MJW411/SIMPLX-SECOND-BARRIER/src/omx_core/config/default.yaml

# 시스템 설정. 현장 튜닝 값은 여기(또는 data/settings.json 의 제어판 변경값)에만 둔다.

robot:
  backend: real            # real | sim  (sim: 로봇 없이 시험)
  port: auto               # auto: /dev/serial/by-id 의 ROBOTIS 장치 (전원 재투입으로 ttyACM 번호가 바뀌어도 찾음)
  baud: 1000000
  ids: {joint1: 11, joint2: 12, joint3: 13, joint4: 14, joint5: 15, gripper: 16}
  control_hz: 50
  # 시간 기반 프로파일(Drive Mode 4)의 프로파일 시간(ms). 짧은 목표를 50Hz로 흘려보내므로
  # 프로그램이 죽어도 로봇은 마지막 작은 목표에서 멈춘다.
  profile_time_ms: 120
  profile_acc_ms: 40
  # 접힌 휴식 자세 (토크 끄기 전 이동). 공식 "home"은 j2=-1.57 이지만 실측 기구 멈춤점(-1.555)에 기대므로 -1.52.
  rest_pose: [0.0, -1.52, 1.57, 1.57, 0.0]
  home_after_done: true    # 정한 반복 횟수를 다 마치면 홈 자세로 복귀 (2026-10-12 사용자). 정지 버튼·안전 정지로 멈출 때는 복귀하지 않음
  bus_watchdog_ms: 0       # 0=끔. Dynamixel Bus Watchdog (20ms 단위로 반올림)
  # 그리퍼(XL330) 위치 이득. 모터 값(P 250 I 0 D 600)으로는 기구 마찰 때문에 목표보다 약 0.1 rad 덜 갔다
  # (2026-10-07 실측: 0.5→0.385, 0.9→0.79, 0→0.084, 전류는 한도의 30% 미만). 힘은 여전히 전류 한도(그리퍼 힘 %)로 묶인다.
  gripper_gains: {p: 500, i: 50}
  # 팔 관절 위치 이득 (XL430 기본 P 640 I 0 D 4000 — I 가 0 이라 중력·물건 무게로 처진 만큼이 그대로 남았다).
  # 2026-10-12: 팔을 뻗고 물건을 들면 어깨가 약 0.08 rad 처짐 → I 이득을 줘 모터가 스스로 되돌리게. 적은 것만 바꾼다.
  # 떨리거나 목표를 지나치면 I 를 줄인다.
  arm_gains: {joint2: {i: 300}, joint3: {i: 300}, joint4: {i: 150}}

camera:
  source: realsense        # realsense | video
  video_path: ""           # source=video 일 때 재생할 파일 (녹화 영상으로 시험)
  width: 640
  height: 480
  fps: 30                  # 2026-09-27: 15 → 30 (최적화로 여유 생김 — 화면 매끄럽고 판단 주기 67 → 33 ms)

perception:
  model: v2_best.engine       # ~/models 또는 data/models 안의 파일 이름. v2 통합 모델: 0=fall-down 1=helmet 2=human
  # direct: .engine 을 torch·ultralytics 없이 TensorRT 로 직접 실행 (실측 프로세스 1416 → 461 MB, 같은 검출 결과)
  # ultralytics: 기존 방식 (.pt/.onnx 는 항상 이쪽)
  backend: direct
  conf: 0.60               # 사람 인식 최소 확신도. 로봇이 person 0.60~0.63으로 잡혀 사용자 요청으로 0.30→0.60 (손 검출이 줄 수 있음)
  imgsz: 640
  # 사람으로 볼 클래스 '이름' (번호는 모델마다 다름). 넘어진 사람(fall-down)도 사람 — 거리·사라짐·재가동 검사에 모두 들어감.
  # COCO 모델이면 person 이 쓰인다. 이 중 하나도 없는 모델은 '인식 모델 없음'으로 고장 정지.
  person_classes: [human, fall-down, person]
  fallen_classes: [fall-down]   # 넘어진 사람 (낙상 알림·녹화용. 정지 판단에는 쓰지 않음)
  show_classes: [helmet]        # 작업 구역 영상에 마스크로 함께 표시만 하는 클래스 (안전 판단에는 안 씀, 2026-10-12)
  min_depth_pixels: 30
  depth_range: [0.12, 4.0]
  max_points: 400          # 사람 한 명당 거리 계산에 쓰는 3D 점 수 (다운샘플)
  stale_timeout: 1.0       # 인식 결과가 이 시간 이상 갱신 안 되면 고장(정지)
  min_brightness: 30       # 영상 평균 밝기가 이보다 1.5초 이상 낮으면 인식 불가 → 고장 정지 (불 꺼진 방)
  # 로봇 자기 오검출 필터: 사람 마스크의 max_frac 이상이 로봇 색(주황)이면 사람이 아니라 로봇으로 본다.
  # (실기 시험에서 움직이는 OMX 팔이 person 으로 간헐 검출돼 사라짐 정지가 걸린 문제 대응)
  robot_filter: {enabled: true, hsv_lo: [2, 190, 70], hsv_hi: [13, 255, 255], max_frac: 0.25}

safety:
  profile: figure          # figure(피규어 시연) | human(실제 사람)
  profiles:
    figure: {slow: 0.18, stop: 0.12, clear: 0.20}   # 13cm 피규어 = 실제 사람(약 166cm)의 1/12.8. ISO 13855 기준 정지 1.54 / 감속 2.30 / 해제 2.56m를 축소 (2026-10-09)
    human:  {slow: 2.30, stop: 1.54, clear: 2.56}   # ISO 13855: S = K·T + C = 1600mm/s × 0.43s + 850mm ≈ 1.54m, 감속 = 정지 + K·T, 해제 = 감속 + 0.26m (2026-10-09)
  # 제어판에서 저장할 수 있는 최소 정지 거리 (m). 실제 사람 기준이 5cm 로 덮어써져 있던 문제(2026-10-08) 재발 방지
  profile_min_stop: {figure: 0.03, human: 0.30}
  slow_scale: 0.35         # 감속 시 속도 배율
  confirm_frames: 3        # 연속 N 프레임 같은 판정이어야 감속/정지 진입 (30fps 에서 0.1초; 15fps 때 2프레임 = 0.13초)
  # 감시 구역 (로봇 베이스 기준, m). 보정 전에는 카메라 기준.
  zone_base: {x: [-0.6, 0.9], y: [-0.8, 0.8], z: [-0.2, 1.2]}
  # 사라짐 판정
  vanish_grace: 1.0        # 이 시간 안에 같은 위치에서 다시 보이면 사라짐 아님 (s)
  vanish_min_frames: 6     # 연속 N 프레임 이상 보인 사람만 사라짐 대상 (깜박이는 오검출 제외, 30fps 에서 0.2초)
  vanish_match_radius: 0.15  # 직전-현재 검출 1:1 매칭 반경 (m)
  vanish_match_iou: 0.3      # 또는 박스가 이만큼 겹치면 같은 사람 (넘어질 때 몸 중심이 크게 움직여도)
  fall_confirm_sec: 3.0      # 넘어진 사람이 이 시간 넘게 계속 보이면 낙상 알림·녹화 + 제어판 확인 팝업. 정지는 하지 않음
  fall_min_conf: 0.60        # 낙상으로 셀 최소 확신도 (2026-10-12 사용자: 60% 이상 3초 이상)
  fall_gap_sec: 0.5          # 이만큼 이하로 잠깐 놓친 건 계속 보인 것으로 (인식 깜빡임)
  fall_clear_frames: 30      # 넘어진 사람이 N 프레임 안 보이면 낙상 상태 해제
  exit_border_px: 40       # 화면 가장자리 이 폭 안에서 사라지면 출구로 본다
  door_roi_px: null        # [x1,y1,x2,y2] 출입문 영역 (이미지 좌표)

recording:
  segment_sec: 2
  keep_sec: 60
  fps: 15                  # 사고 영상 프레임 (10 → 15, 최적화로 여유)
  jpeg_quality: 70
  segment_dir: /dev/shm/omx_segments
  pre_sec: 8               # n
  post_sec: 16             # m (사람·사라짐)
  conveyor_post_sec: 16    # L (컨베이어)
  limits: {pre_max: 50, post_max: 120}

storage:
  # 데이터 폴더는 OMX_DATA_DIR 환경 변수로 정한다 (없으면 ~/omx_data). 시험은 임시 폴더를 지정.
  budget_ratio: 0.50       # SSD 전체 용량 대비 데이터 예산

conveyor:
  travel_timeout: 15.0     # 컨베이어가 돌기 시작한 뒤 도착 센서(D5)까지 제한시간 (s, 0=끔). 넘으면 정지 + 이상 이벤트·녹화·알림
  start_sensor: true       # 투입 센서(D6)에 물품이 올라오면 출발. false 면 작업 중 도착 센서가 빌 때마다 계속 돌림(예전 방식)
  arrive_sensor: true      # false = 도착 센서(D5)로 멈추지 않음 (센서 고장 시 임시. 아두이노도 안 멈춤 — 펌웨어 v4.1 이상)
                           # 2026-10-12 펌웨어 v4.3 재배선: 도착 센서 D5, 투입 센서 D6, 문 서보 D4
  auto_clear_sec: 0        # 컨베이어 이상이 걸린 뒤 이 시간(s)이 지나면 저절로 해제하고 로봇 작업을 이어서 함 (0 = 끔).
                           # 2026-10-12 사용자: 끔 — 제어판 '공정 이상' 팝업의 재가동 버튼으로 다시 실행.
                           # 물품이 도착 센서에 닿음·투입 센서에 새 물품·작업 새로 시작으로도 풀림
  resume_pose: place       # 컨베이어 이상으로 일시 정지된 로봇 작업이 재개될 때 먼저 이 티칭 자세로 가서 물품이 도착 센서(D5)에
                           # 올 때까지 기다린 뒤 이어서 함 (빈 값 = 멈춘 단계부터 바로 이어서)

devices:
  backend: arduino         # virtual | arduino  (--sim + 영상 파일 시험은 항상 virtual)
  arduino_port: auto       # auto: /dev/serial/by-id 의 FT232R·CH340 (로봇 장치 제외), 없으면 첫 /dev/ttyUSB*
  arduino_baud: 9600       # 스케치(arduino/omx_io)와 같아야 함. 네오픽셀 때문에 9600

door:
  close_sec: 5.0           # 헬멧 확인(또는 수동 열기) 뒤 이 시간이 지나면 닫힘. 화재 중에는 계속 열림

helmet:
  enabled: true
  camera: auto             # auto: /dev/v4l/by-id 에서 RealSense 가 아닌 첫 카메라
  fps: 5                   # 추론 프레임 (카메라는 30fps 로 받고 이만큼만 압축을 푼다)
  # 모델: 사람 인식과 같은 통합 모델을 다른 실행 통로로 같이 쓴다 (perception.model)
  match: presence          # head: 사람 머리 영역에 헬멧이 겹쳐야 착용 | presence: 사람과 헬멧이 함께 보이면 착용
                           # 2026-10-08 실기: 입구 카메라가 피규어를 가깝고 비스듬히 봐서 head 가 미착용으로 오판 → presence
  head_frac: 0.35          # head 방식: 사람 박스 위쪽 이 비율을 머리 영역으로 본다
  person_conf: 0.50        # 사람 검출 최소 확신도
  always: true             # 항상 판정 (피규어 시연: 서 있는 동안 계속 판정, 헬멧이면 문 열림 유지). false = 움직일 때만
  hold_sec: 3.0            # 움직임이 멈춘 뒤에도 이만큼 더 추론 (멈춰 선 사람도 연속 확인되게)
  conf: 0.50
  confirm_frames: 3        # 연속 N 프레임 착용이어야 문 열림 (5fps 에서 0.6초)

web:
  host: 0.0.0.0
  port: 8000
  users: {admin: omx1234}  # 첫 로그인 후 바꿀 것
