MJW411/SIMPLX-SECOND-BARRIER/(commit log)

2026-10-08 기존 ROS 2 패키지 보관 (COLCON_IGNORE)
    omx-safety-demo를 ROS 2 5-프로세스 구조로 이전하기 전의 기준점.
    기존 비전 감시 패키지는 빌드에서 제외하고 참고용으로 남긴다.
2026-10-08 omx_core: omx-safety-demo 원본 코드 복사 (변경 없음)
    demo 2e30b8a 이후 작업 트리 기준 (git 손상으로 커밋 해시 대신 2026-10-08 스냅샷).
    기준선 테스트: test_core 63 OK, test_io 42 OK, test_db OK, test_gpu 6 OK.
2026-10-08 omx_core: v2 통합 모델 적용과 인식·안전 허점 수정 (2단계)
    - 엔진 1개 + 실행 컨텍스트 2개(사람·헬멧 레인), 모델 교체 시 GPU 버퍼 해제
    - GPU 후보 선택을 클래스 비트마스크로 확장: human+fall-down 도 GPU 경로 (CPU 경로와 결과 동일)
    - 사람 클래스를 이름으로 조회, Person.fallen / Percept.model_ready 추가
    - 모델 로딩 실패·사람 클래스 없는 모델 → 인식 고장 정지, 교체 시 클래스·파일 이름 검증
    - 신선도를 프레임 시각 기준으로, 카메라 새 프레임 대기(5ms 폴링 제거)
    - 헬멧 게이트: 사람 머리 영역의 헬멧(head) / 동시 검출(presence), 예외 처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
2026-10-08 omx_core·omx_interfaces: 다중 프로세스 준비와 4단계 허점 수정
    - omx_interfaces: 노드 사이 메시지(People/Permit/RobotState/SafetyState/IoState/HelmetState/Event/ClipStatus)와 Command 서비스
    - Config: 설정 폴더 탐색(OMX_CONFIG_DIR/소스/ament), 데이터 폴더 기본 ~/omx_data,
    settings.json 파일 잠금 저장(다른 노드 값 보존) + reload
    - 녹화: 데이터 폴더별 조각 폴더, 쓰기·인코딩 예외 처리, ffmpeg 에 조각을 바로 흘려 SSD 이중 복사 제거
    - DB: 클립을 clips 폴더 기준으로 삭제(파일이 안 지워지던 버그), 이벤트 키 중복 방지, 시작 시 정리,
    사용량·통계 캐시, (type, acked)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
2026-10-08 ROS 2 5-프로세스 구조로 이전 (perception/safety/robot/io/web)
    - omx_nodes: 노드 5개 + 웹 제어판(데모와 같은 API·응답). 기존 판단·실행 코드는 대리 객체로 그대로 사용
    (ExecutorProxy/PerceptionProxy/IoProxy/SafetyProxy, 끊기면 안전 쪽으로)
    - 공통: 단일 스레드 실행기 + 명령은 작업 스레드, 바뀔 때만 보내는 상태, 볼 때만 보내는 스냅샷
    - 경합 수정: 동작 전 정비·화재 검사와 화재 상황 종료는 해당 노드의 지금 값으로,
    상황 종료 전 화재 값 무시, 명령 후 즉시 상태·스냅샷 발행, 웹은 첫 상태 수신 후 열기
    - 비상정지: /omx/estop 토픽으로 실행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
2026-10-08 장치 잠금: 실제 장치마다 배타 잠금, 백업 데모와 동시 실행 방지
    같은 OpenRB·아두이노·카메라를 두 프로그램이 함께 잡지 않게 한다. 데모의 잠금 파일에는 공유 잠금만 건다(내용 그대로).
2026-10-08 tools/live_view.py: v2 모델 실시간 확인 뷰어 (작업대·입구 카메라, 모든 클래스·확신도·거리)
2026-10-08 tools/upload_arduino.sh: 아두이노 펌웨어 업로드 (데모에서 가져옴)
2026-10-08 아두이노 omx_io v4 + 컨베이어 투입 센서 출발
    - 배선 v4 (사용자 시험 스케치 기준): 투입 D11·도착 D12 IR(감지 시 LOW), 화염 A0, 서보 D6, 모터 D9/D10,
    조명 D13(16개, 항상 백색), 대피 유도 D3(60개)
    - D3: 평상시 은은한 백색, 화재(불꽃 직접 감지 또는 젯슨 Y) 시 노란 물결이 입구 쪽으로 흐름
    - 서보는 움직일 때만 신호(LED 갱신 시 떨림 방지), 60개 LED 갱신은 시리얼 수신·서보 이동 중 미룸
    - 상태 줄 s1 = D11 투입 (v3 는 항상 0)
    - ConveyorMonitor: 작업 중 투입 센서에 물품이 있으면 출발, 도착까지 계속 (conveyor.start_sensor, 기본 true)
    - 시험: test_io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
2026-10-08 omx_io v4: 대피 유도 물결 간격 6칸·꼬리 5칸, 수신 대기 제거로 시험 스케치처럼 부드럽게
2026-10-08 omx_io v4: 대피 유도 물결 밝기 80% (사용자 조정)
2026-10-08 web_node: 자원 측정 스레드가 접속 수를 만들기 전에 읽던 순서 수정
2026-10-08 화재 홈 복귀: 팔만 움직이고 그리퍼는 지금 위치 유지
    저장된 홈 자세의 그리퍼 값이 한계를 살짝 벗어나(-0.02) 화재 홈 복귀 전체가 거부되던 문제 (2026-10-08 실기).
    대리 객체 current_q 도 실행기처럼 그리퍼를 한계 안으로.
2026-10-08 omx_io v4: 불꽃 센서 보류 — 감지 끔(FLAME_ENABLED=false), 기준값 300 (사용자 시험 스케치)
    실기: 단품 수광 소자 + 풀다운이 LED·조명 빛에 1023 포화 → 화재 오판, 센서 제거 후 A0 가 떠서 84~109 로 기준(100) 오르내림.
2026-10-08 헬멧 게이트: 움직임이 멈춘 뒤 3초 더 추론(hold_sec), 판정 방식 presence
    실기: 피규어를 놓고 손을 떼면 바로 '움직임 없음'이 돼 확인 횟수가 지워지고 박스가 사라짐.
    입구 카메라가 피규어를 가깝고 비스듬히 봐서 head(머리 영역) 판정이 미착용으로 오판 → 계획대로 presence 로 전환.
2026-10-08 헬멧 게이트: always 설정(기본 true) — 피규어 시연은 서 있는 동안 계속 판정
2026-10-08 벽면 LED 상태 색, 반복 횟수·작업 완료, 시간 한도 없앰, 제어판 표시 정리
    - 벽면 D13: 사람 감속 주황(O), 사람 정지 빨강(R, 재가동 전까지·사라짐 포함), 작업 완료 초록(C), 그 밖 백색
    (SafetyState.human_alarm, RobotState.cycle_done 추가)
    - 작업: 반복 횟수 입력(0 = 정지할 때까지), 횟수를 마치면 cycle_done 이벤트·제어판 팝업·벽면 초록,
    다음 시작·정지 때 해제. 4분 시간 한도 없앰(cycle_max_minutes 0 = 끔)
    - 제어판: 한국어 단어 단위 줄바꿈·버튼 한 줄('반복 시작'의 '작'만 내려가던 문제), 로고 'Second Barrier / Robot_safety',
    불빛·장치 설명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
2026-10-08 컨베이어 이상 자동 해제: 물품이 도착 센서에 닿거나 작업을 새로 시작하면
    장치 노드가 건 이상·푼 시각을 직접 기억해, 안전 노드 상태가 늦게 와도 판단이 엇갈리지 않게 함.
    관리자 해제 버튼은 그대로. 시험: test_io 자동 해제 사례 추가.
2026-10-08 사라짐: 네 가장자리 출구·들려 나감 판정, 컨베이어 이상 시 로봇 작업 정지
    - 사라짐 출구에 위·아래 가장자리 포함 (위로 나가는 손이 사라짐이 되던 문제)
    - 들려 나감: 사라진 사람 자리에 겹쳐 있던 검출(피규어를 집은 손)이 이어서 출구로 나가면 대기 중인 사라짐을 지움
    - 컨베이어 이상(제한시간 초과)이면 작업 순서도 정지 → 다시 시작하면 이상 자동 해제
    - 시험: test_safety_v2 사라짐 4가지, test_io 작업 정지 (모두 통과)
2026-10-09 컨베이어 이상 시 로봇 작업 일시 정지, 해제되면 자동 재개
    - 15초 동안 물품이 도착하지 않으면 컨베이어 정지 + 로봇 작업 일시 정지 (끝내지 않음)
    - 투입 센서(D11)에 물품이 새로 올라오면(없다가 생김) 이상 자동 해제
    - 도착 센서 감지·해제 버튼·작업 새로 시작으로 풀려도 똑같이 재개
    - 재개하면 멈춘 단계부터 다시, 반복 횟수는 이어서
    - 제어판 작업 표시에 '일시 정지'
2026-10-09 컨베이어 이상으로 일시 정지되면 로봇은 place 자세로 가서 대기
    - 설정 conveyor.pause_pose (기본 place, 빈 값이면 멈춘 자리에서 대기)
    - 그리퍼는 그대로 (쥔 물체 유지), 이동 속도 50%
    - 재개: 관절 이동 단계는 바로 목표로, 그 밖의 단계(직선 이동·그리퍼·센서 대기)는 멈춘 자리로 먼저 복귀
    - 자세가 없거나 못 가면 멈춘 자리에서 대기
2026-10-09 컨베이어 이상 재개 시 place 자세로 가서 물품 도착을 기다린 뒤 이어서
    - 일시 정지 동안은 멈춘 자리에 그대로 (움직이지 않음)
    - 재개하면 conveyor.resume_pose(기본 place)로 가서 도착 센서(D12)에 물품이 올 때까지 대기
    - 그 뒤 멈춘 단계부터: 관절 이동은 바로 목표로, 그 밖의 단계는 멈춘 자리로 먼저 복귀
    - 멈췄다 곧바로 풀려도 취소된 동작을 작업 실패로 보지 않고 다시 함 (경합 수정)
2026-10-09 제어판 디자인: 밝고 전문적인 테마로
    - 연회색 바탕 + 흰 카드(얇은 테두리·옅은 그림자) + 남색 글씨 + 파란 포인트
    - 상태(정상·감속·정지·컨베이어)·태그·경고 상자를 밝은 바탕에 맞는 색으로
    - 버튼: 흰 기본 / 파랑·초록·주황·빨강은 흰 글씨, 메뉴·탭 선택은 연파랑
    - 카메라 영상, 비상정지 버튼, 화면 경보는 그대로
2026-10-09 로봇 작업 일시 정지·재개를 이벤트 목록에 남김
    - cycle_pause / cycle_resume: 컨베이어 이상으로 멈춘 때, 해제되어 이어서 한 때를 제어판에서 확인
2026-10-09 관절 각도 이상(robot_angle)을 이벤트 목록에서 제외
    - 새로 저장하지 않고 로봇 기록 파일에만 남김
    - 이미 저장된 기록도 목록·미확인 수에서 빠지고 공간 정리 대상이 됨
2026-10-09 도착 센서 고장 시 임시 설정: 작업 중이면 컨베이어 계속 가동 (conveyor.arrive_sensor)
    - arrive_sensor=false: 젯슨은 도착 센서를 보지 않고, 아두이노에도 'C .. .. . 0'으로 D12 정지를 끄게 함
    - 펌웨어 omx_io v4.1: 명령 다섯째 값 0 이면 D12로 멈추지 않음, 없거나 연결 끊기면 기본(정지)
    - 기본값 true (예전과 같음), 예전 펌웨어도 다섯째 값은 무시하고 동작
2026-10-09 omx_io v4.2: 도착 센서 D11, 투입 센서 D12로 바꿈
    - D12 줄이 계속 LOW(감지)로 붙어 있어 정상인 센서를 D11에 두고 도착 센서로 씀
    - 상태 줄 순서(s1 투입, s2 도착)는 그대로라 젯슨 쪽 코드는 바뀌지 않음
    - 제어판·설정 설명의 핀 번호도 맞춤
2026-10-09 제어판 시각화: 거리 기준 막대, 감시 구역 지도, 컨베이어 도착 시간 차트
    - 모니터링 안전 카드: 정지·감속·대기·여유 구간 막대 + 가장 가까운 사람 거리 실시간 표시
    - 설정 거리 기준: 입력값으로 같은 막대 미리 보기 (순서가 틀리면 경고)
    - 모니터링 감시 구역 지도: 위에서 본 로봇 팔·정지/감속 띠·사람 위치(넘어짐 표시), 보정 전이면 안내
    - 입출력 컨베이어: 최근 20회 도착 시간 막대, 이상(빨강), 제한시간·평균 선, 가동 중 진행 막대
    - 인식 스냅샷에 사람 위치·로봇 링크점, 컨베이어 스냅샷에 도착 기록 추가 (SVG, 외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
2026-10-09 제어판: 안전 관제 화면으로 디자인 개편, 사고 현황 도넛, 이벤트·영상 분류
    - 관제 화면 방식(ISA-101): 회색 바탕·남색 메뉴, 색은 상태·경보에만, 숫자 고정폭, 카드 머리줄
    - 상단: 운전 상태 블록, 활성 경보 줄(빨강), 시계, 비상정지 / 아래 장치별 상태 줄 9칸
    (안전 구역·사람·로봇·작업·컨베이어·출입문·화재·인식·노드, 이상은 색·깜빡임)
    - 대시보드 사고 현황: 기간(24시간·7일·30일·전체)별 사고 종류 도넛 + 순위 표 + 가장 많은 사고
    - 이벤트 화면 분류 탭 (사람·안전/화재/로봇/컨베이어/작업/운영·설정, 미확인 수)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
2026-10-09 제어판 통계 탭: 작업량·사이클 시간·이벤트 발생률 대시보드
    - 핵심 숫자 6칸: 총 작업, 하루 평균 작업량(가동일 기준 함께), 평균 사이클 시간, 사고 건수, 100회당 사고, 하루 평균 사고
    - 일별 작업량 막대 + 평균선, 사고 유형 도넛, 이벤트 발생률 표(하루 평균·100회당, 사고는 색), 시간대별 작업량, 일별 사고 누적 막대
    - 기간: 오늘·7일·30일·90일, 1분마다 갱신. /api/stats
    - 작업 1회마다 cycle_tick(걸린 초)을 통계용으로만 저장 (이벤트 목록·알림엔 안 나옴).
    기록 전 날짜는 작업 완료·정지 이벤트의 횟수로 계산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
2026-10-09 모니터링 배치: 감시 구역 지도를 오른쪽(안전 아래), 사고 현황·로봇을 왼쪽(카메라·숫자 아래)으로
2026-10-09 모니터링 배치: 사고 현황·로봇을 맨 아래 한 줄에 나란히
2026-10-09 컨베이어: 안전 정지(사람 정지·사라짐·고장) 동안 컨베이어도 정지, 재가동되면 이어서 가동
2026-10-09 모니터링: 사고 현황·로봇 카드 제거 (통계 탭·로봇 탭에 같은 정보)
2026-10-09 거리 막대: 감속·재가동 허용 눈금 숫자가 겹치지 않게 벌림
2026-10-09 거리 막대 눈금 숫자 글씨 줄임 (11 → 9px, 거리 막대만)
2026-10-09 피규어 거리 기준 정지 0.12 / 감속 0.18 / 해제 0.20 m (ISO 13855 실제 사람 기준을 1/12.8 축소)
2026-10-09 실제 사람 거리 기준 ISO 13855 기반 정지 1.54 / 감속 2.30 / 해제 2.56 m
2026-10-12 omx_io v4.3: 재배선 — 도착 D5 · 투입 D6 · 문 서보 D4 (제어판 표기도 맞춤)
2026-10-12 gitignore: 직접 빌드한 커널 모듈(*.ko) 제외
2026-10-12 제어판: 모니터링 안전 카드에 입구 카메라(헬멧) 영상·판정, 사이드바 진한 파랑·큰 글씨
2026-10-12 제어판 사이드바 색 #0081FF
2026-10-12 제어판: 화면 표시 이름에서 OMX 제거
2026-10-12 제어판: 통계 일별 사고 추이 삭제·한 화면에 맞춤, 모니터링 감시 구역 지도 → 입구 카메라·헬멧
2026-10-12 제어판: 로봇·작업 탭 합침
2026-10-12 제어판: 로봇·작업 화면 3열 배치, 한 화면에 꽉 차게
2026-10-12 제어판: 출입문 닫힘 시간·출구 영역을 설정 → 출입문·출구로 옮김
2026-10-12 제어판: 입출력의 입구 카메라·헬멧 칸 삭제, 지금 문 열기를 설정 → 출입문·출구로
2026-10-12 제어판: 입출력 탭 삭제, 컨베이어 이상 해제 버튼을 모니터링 안전 칸으로
2026-10-12 제어판: 입구 카메라 영상에 CAM 02 · 입구 라벨
2026-10-12 제어판: 넓은 화면(1600px 이상) 글자 약 10% 크게
2026-10-12 컨베이어 이상 10초 지나면 자동 해제(수동 버튼 유지), 펌웨어 v4.4 불꽃 센서 화재 감지 켬
2026-10-12 펌웨어 v4.4: 화재 때 벽면 LED 주황, 바닥 대피 물결 꼬리 길게
2026-10-12 컨베이어 이상: 해제 버튼 대신 '공정 이상' 팝업 + 재가동 버튼, 시간 자동 해제 끔
2026-10-12 화재 홈 복귀 실패 수정: 저장 자세의 한 바퀴 넘긴 각도·한계 살짝 넘은 값 보정, 대피 물결 꼬리 길게·간격 좁게
2026-10-12 펌웨어 v4.4: 불꽃 센서 기준 방향 바로잡음(600보다 낮으면 불꽃), 화재 때 벽면·바닥 같은 색
2026-10-12 펌웨어 v4.4: 불꽃 기준 750 (라이터 실측 290~700, 평상시 849~1003)
2026-10-12 펌웨어 v4.4: 불꽃 기준 100 이하일 때 화재
2026-10-12 프로그램: 시작 전(Before Start) 구간 — 반복 전에 한 번만 하는 단계
2026-10-12 직선 이동(MoveL)도 한계를 살짝 넘은 관절값 보정 — 손목 멈춤점까지 꺾어 티칭한 자세로 가는 직선 이동 거부 수정
2026-10-12 팔 처짐 보완: 어깨·팔꿈치·손목 위치 I 이득(300/300/150), 손목 출력 제한 60→80%
2026-10-12 제어판: 모니터링 안전·입구 카메라 칸과 통계 탭 글씨 크게 (줄내림 없이)
2026-10-12 제어판: 모니터링 안전·입구 카메라 칸과 통계 탭 글씨 진하게
2026-10-12 제어판: 입구 카메라 칸에 GATE OPEN/CLOSED 크게, 통계 날짜·숫자 아래 설명은 보통 굵기
2026-10-12 제어판: 입구 카메라 칸 오른쪽을 영상 높이 2행(판정·검출 / GATE), CLOSED 설명 문구 뺌
2026-10-12 제어판: 삭제된 자세를 쓰는 프로그램 단계 안내 팝업·빨간 표시
2026-10-12 부팅 자동 실행: ros2 launch omx_bringup omx.launch.py 를 systemd 사용자 서비스(omx-launch)로, 웹 재시작이 그 서비스를 다시 시작
2026-10-12 설정 → 안전: 감속 속도(감속 구간 허가 배율) 10~80% 설정, 저장하면 바로 적용
2026-10-12 작업 구역 영상: 사람은 마스크(SEG)와 윤곽선만, 상자(BBOX)는 마스크가 없을 때만
2026-10-12 작업 구역 영상: 헬멧도 노란 마스크로 함께 표시 (표시 전용 — 사람 수·거리·정지 판단에는 안 씀)
2026-10-12 헬멧 판정 문구: '헬멧 착용 확인 - 문 열림' / '헬멧 미착용'
2026-10-12 헬멧 게이트 presence 방식: 사람은 보이는데 헬멧이 없으면 '헬멧 미착용' 표시 (전에는 '사람 확인 중'에 머묾)
2026-10-12 헬멧 게이트: 착용자와 미착용자가 함께 있으면 문 안 열림 (헬멧 하나는 한 사람에게만 짝지음)
2026-10-12 보정 표시·정확도: 로봇 모습 전체를 반투명 하늘색으로 그리고 영상에 보정 일치율 표시, 자동 보정에 작업 방향(PICK·PLACE) 자세 추가 (최대 14자세)
2026-10-12 작업 구역 영상 표시 다듬기: 로봇은 옅은 면·가는 빛 테두리·관절 점(시안 B), 사람·헬멧 테두리 매끈하게, 라벨은 바탕 상자에 겹치지 않게
2026-10-12 제어판: 새 로고(두 겹 방패 + 로봇 팔), 로고·이름 글씨 크게, 사이드바 240px
2026-10-12 영상 표시: 로봇은 다시 팔 위 선(연한 하늘색, 가늘게), 입구 카메라는 헬멧 노랑·사람 초록/빨강 상자에 라벨은 바탕 상자로 겹치지 않게
2026-10-12 낙상: 확신도 60% 이상 3초 넘게 보이면 확정 + 제어판 확인 팝업, 넘어진 사람 분홍 마스크 / 로고 3번 / 설정 화면 갱신 멈춤 수정(cv 정의 빠짐)
2026-10-12 설정 → 안전: 낙상 감지 시간·최소 확신도 설정 (저장하면 바로 적용)
2026-10-12 로봇 제어: 속도 막대 옆 '이 속도로 저장' — 다시 켜도 저장한 속도로 시작 (상한 안에서)
2026-10-12 통계 탭 선명한 색: 숫자 카드별 색띠·숫자 색, 막대 그라데이션, 사고 종류 색 구분, 일반 기록 막대 청록
2026-10-12 모니터링 화면에서는 보정 일치율 표시 숨김 (보정·티칭 화면에서는 보임)
2026-10-12 로고: 두 겹 방패(세컨드 배리어) + 체크, 남색 바탕·초록
2026-10-12 로봇 팔 선 노랑·그리퍼 끝 빨강, 사이드바 로고 영역 크게(로고 58px·사이드바 256px), 운전 상태 옆 글씨 뺌
2026-10-12 비상정지 버튼: 빨강 사각 + 손바닥 아이콘 (E안)
2026-10-12 모니터링: 왼쪽·오른쪽 열 끝선 맞춤(숫자 칸이 늘어남), 속도 저장 버튼 이름 '저장'
2026-10-12 설정 → 안전: 무인 시험 감시 칸 삭제(꺼진 상태 유지), 오른쪽 열 높이를 거리 기준 칸과 맞춤, 자동 보정 안내 문구 14자세로
2026-10-12 로봇 팔 선 흰색, 그리퍼 끝 고리 주황
2026-10-12 모니터링 화면에도 보정 일치율을 작게 표시
2026-10-12 그리퍼 끝(TCP) 표시 빨강
2026-10-12 모니터링: 오른쪽 열이 짧을 때도 입구 카메라 칸이 늘어나 양쪽 끝선이 항상 맞게
2026-10-12 작업 완료(정한 횟수)하면 홈 자세로 복귀 (robot.home_after_done)
2026-10-12 모니터링 오른쪽 열 높이 비율 안전 2 : 입구 카메라 1
2026-10-12 모니터링 오른쪽 칸 안 최적화: 안전 표가 남는 높이를 채움, 입구 카메라 GATE·판정 글자가 칸 폭에 맞춰 크기 조절
2026-10-12 모니터링 오른쪽 열 1:1 — 안전 칸을 줄임(재가동·정비 모드 한 줄, 거리 막대 높이 제한)
2026-10-12 티칭 탭 3열 배치(영상·자세 / 조그·도구 / 그리퍼, 넓은 화면은 한 화면에 꽉 차게), 왼쪽 메뉴 글씨·아이콘 크게
2026-10-12 이벤트 탭에서 작업·운영·설정 기록과 분류 버튼 뺌 (DB·통계에는 그대로), 메뉴 미확인 수도 보이는 분류만
2026-10-12 모니터링: 안전 그래프 크게·표는 2×2로 작게, 입구 카메라 판정 표 작게, 두 표 글씨 조금 크게 (1:1 유지)
2026-10-12 상단 상태 줄 9칸 바탕 연한 노랑~아이보리
2026-10-12 입구 카메라 칸: 판정·검출 표 1 : GATE 표시 1
2026-10-12 상단 상태 줄: 칸 이름·값·설명 글씨 크게, 표시등(동그라미) 8→12px
2026-10-12 상단 상태 줄: 값·설명 가운데 정렬, 표시등 15px
2026-10-12 상단 상태 줄: 값·설명 다시 왼쪽 정렬 (표시등 15px 유지)
2026-10-12 README: 핵심 위주로 정리, 제목 Second Barrier Project
2026-10-12 PROJECT_BRIEF: '인증된 안전장치라고 주장하지 않는다' 문장 삭제
